guntamukkalatanuj-jpg/Dual-Node-BLE-LoRa-Messaging-System/Dual-Node BLE–LoRa Messaging System/docs/circuit diagram/transmitter 2.jpeg

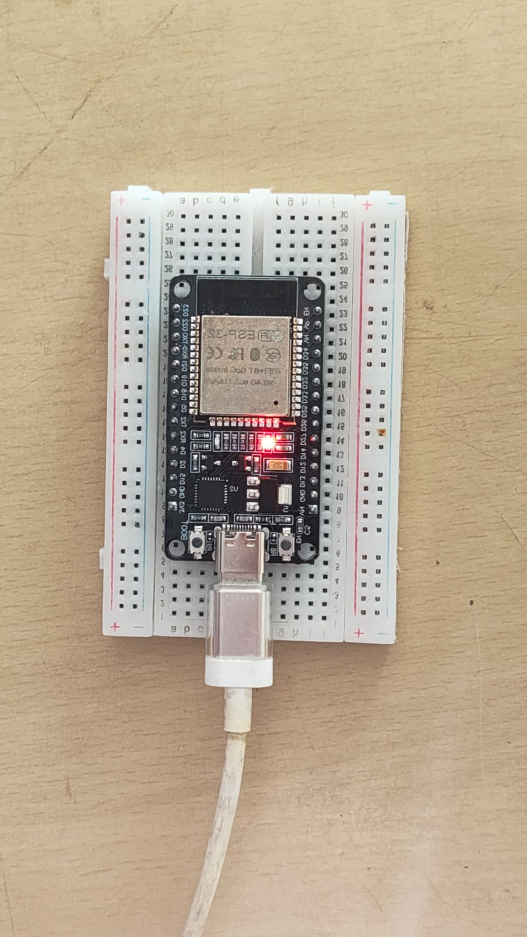
Dual-Node BLE–LoRa Messaging System/docs/circuit diagram/transmitter 2.jpeg
