guntamukkalatanuj-jpg/Dual-Node-BLE-LoRa-Messaging-System/Dual-Node BLE–LoRa Messaging System/docs/circuit diagram/gateway circuit.jpeg

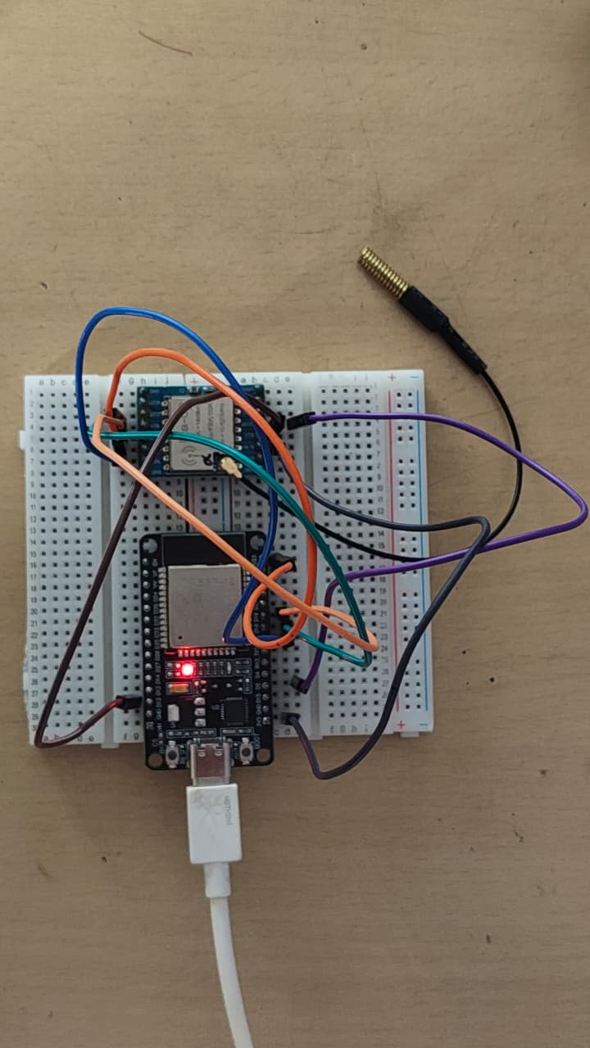
Dual-Node BLE–LoRa Messaging System/docs/circuit diagram/gateway circuit.jpeg
