guntamukkalatanuj-jpg/Dual-Node-BLE-LoRa-Messaging-System/README.md

<div align="center">

GHBanner

  <h1>Built with AI Studio</h2>

  <p>The fastest path from prompt to production with Gemini.</p>

  <a href="https://aistudio.google.com/apps">Start building</a>

</div>
